jiyaagrawal04/Dhvani/diagrams/DHVANI_Clear_vs_Muddy.png

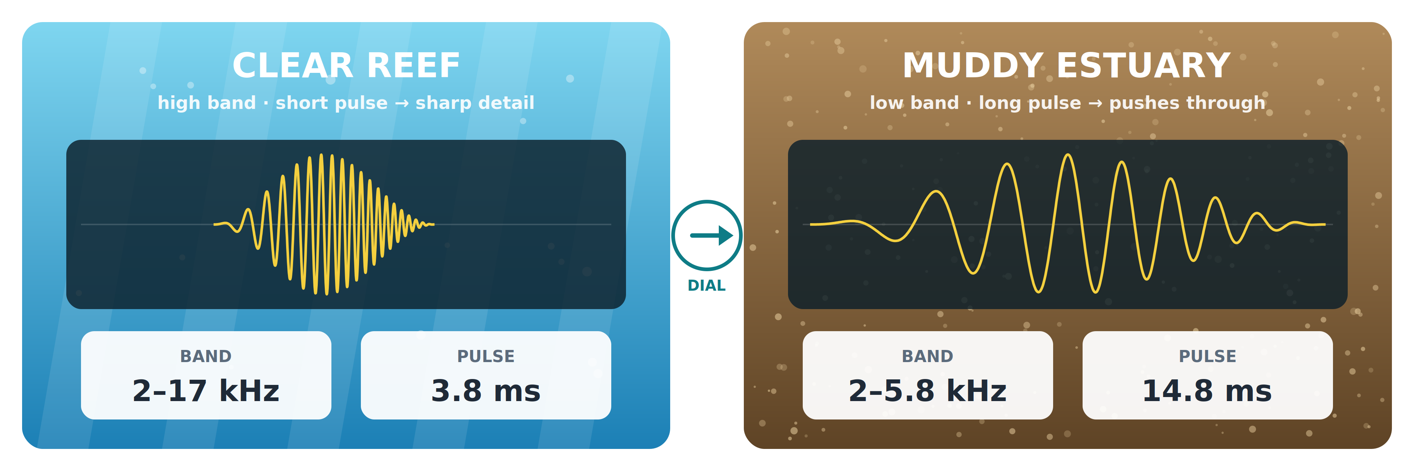
diagrams/DHVANI_Clear_vs_Muddy.png
