jiyaagrawal04/Dhvani/diagrams/DHVANI_Connections.png

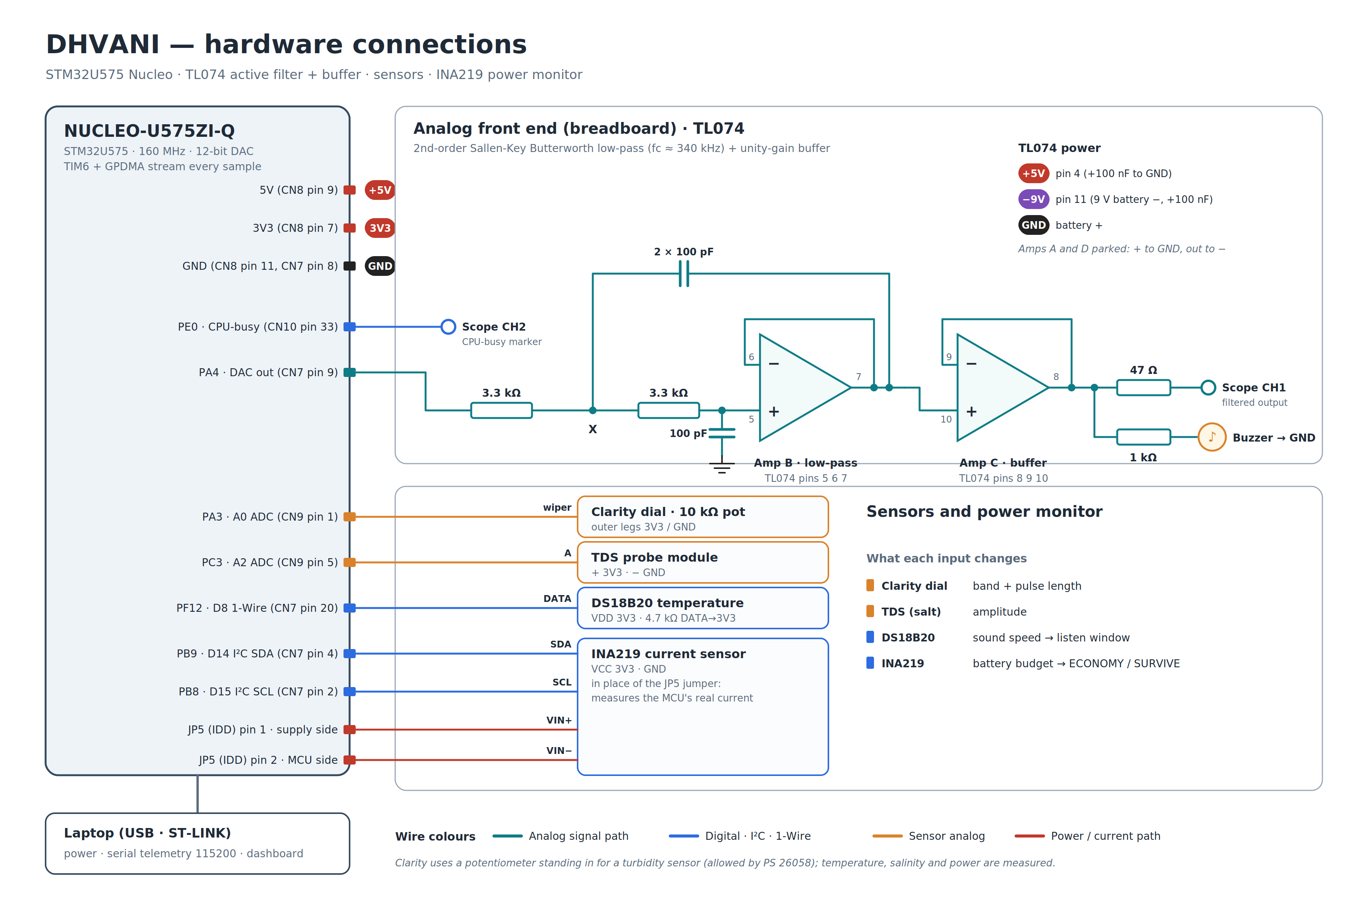
diagrams/DHVANI_Connections.png
