jiyaagrawal04/Dhvani/diagrams/DHVANI_Connections_16x9_4K.png

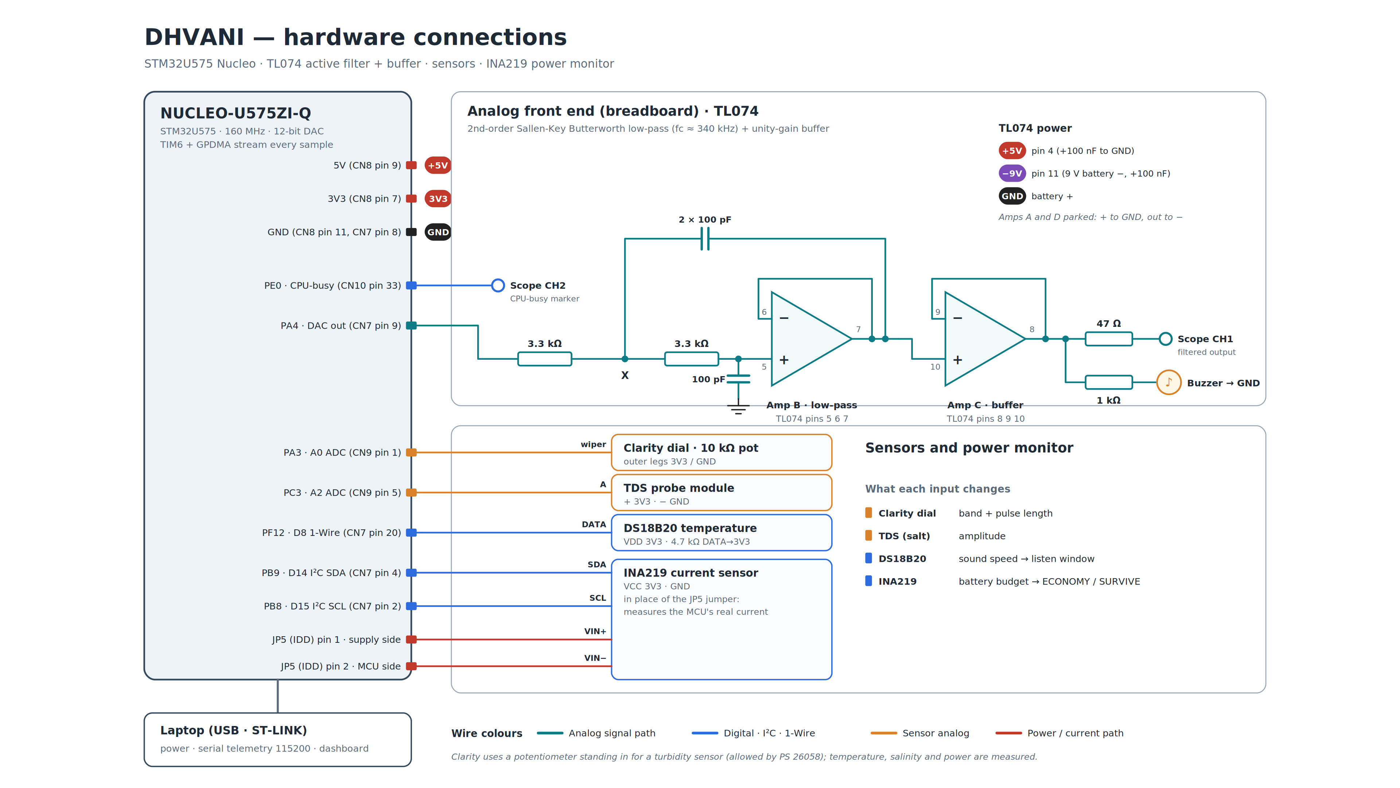
diagrams/DHVANI_Connections_16x9_4K.png
