jiyaagrawal04/Dhvani/diagrams/DHVANI_Pin_Connections.png

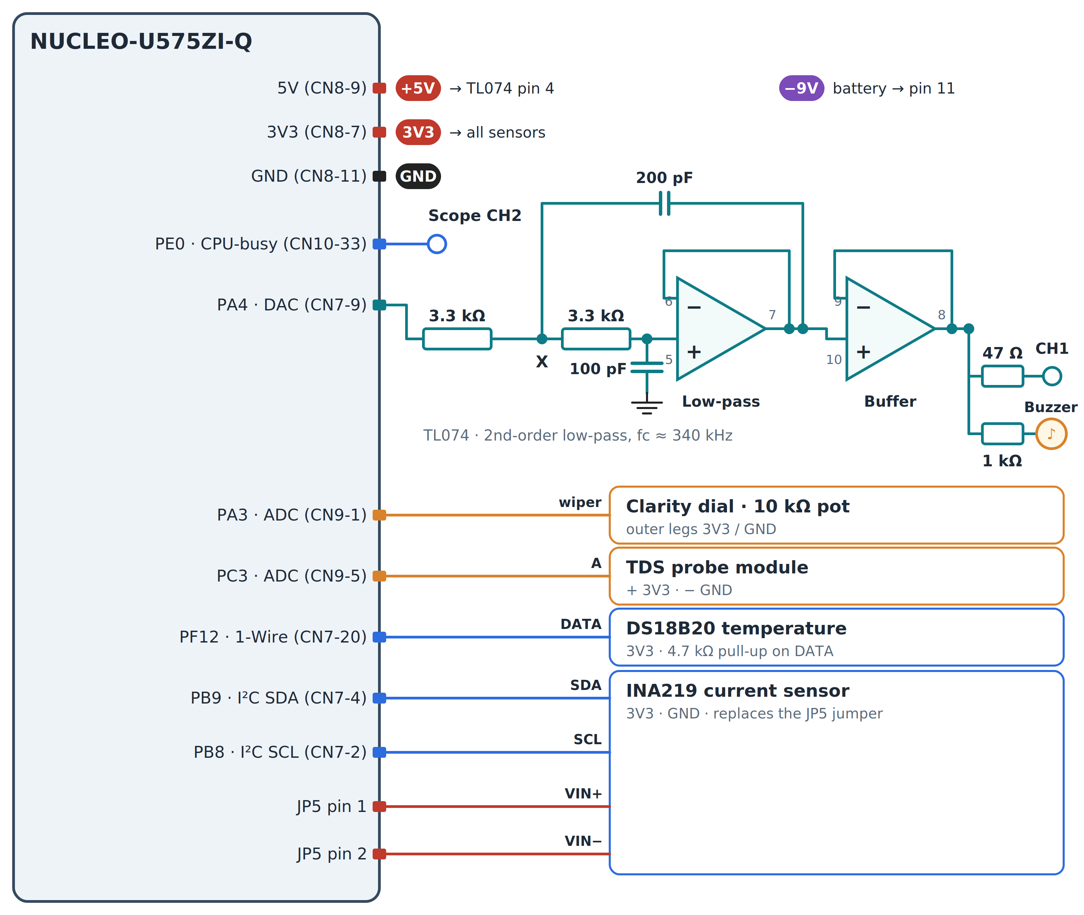
diagrams/DHVANI_Pin_Connections.png
