jiyaagrawal04/Dhvani/diagrams/DHVANI_Pin_Connections_Bold.png

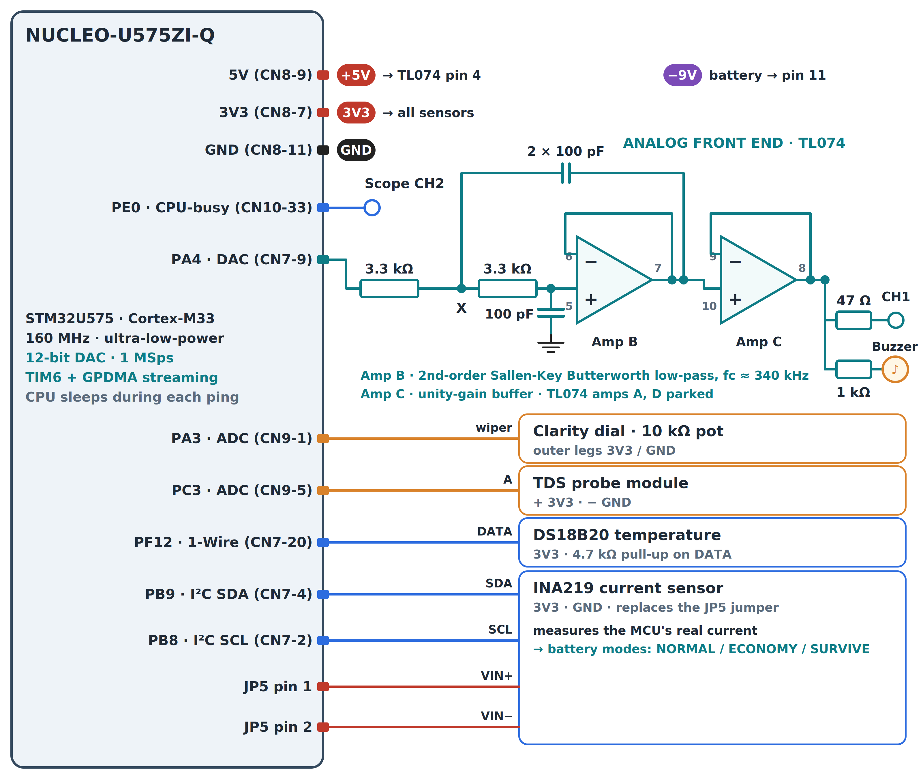
diagrams/DHVANI_Pin_Connections_Bold.png
