jiyaagrawal04/Dhvani/diagrams/DHVANI_Pin_Connections_HalfSlide.png

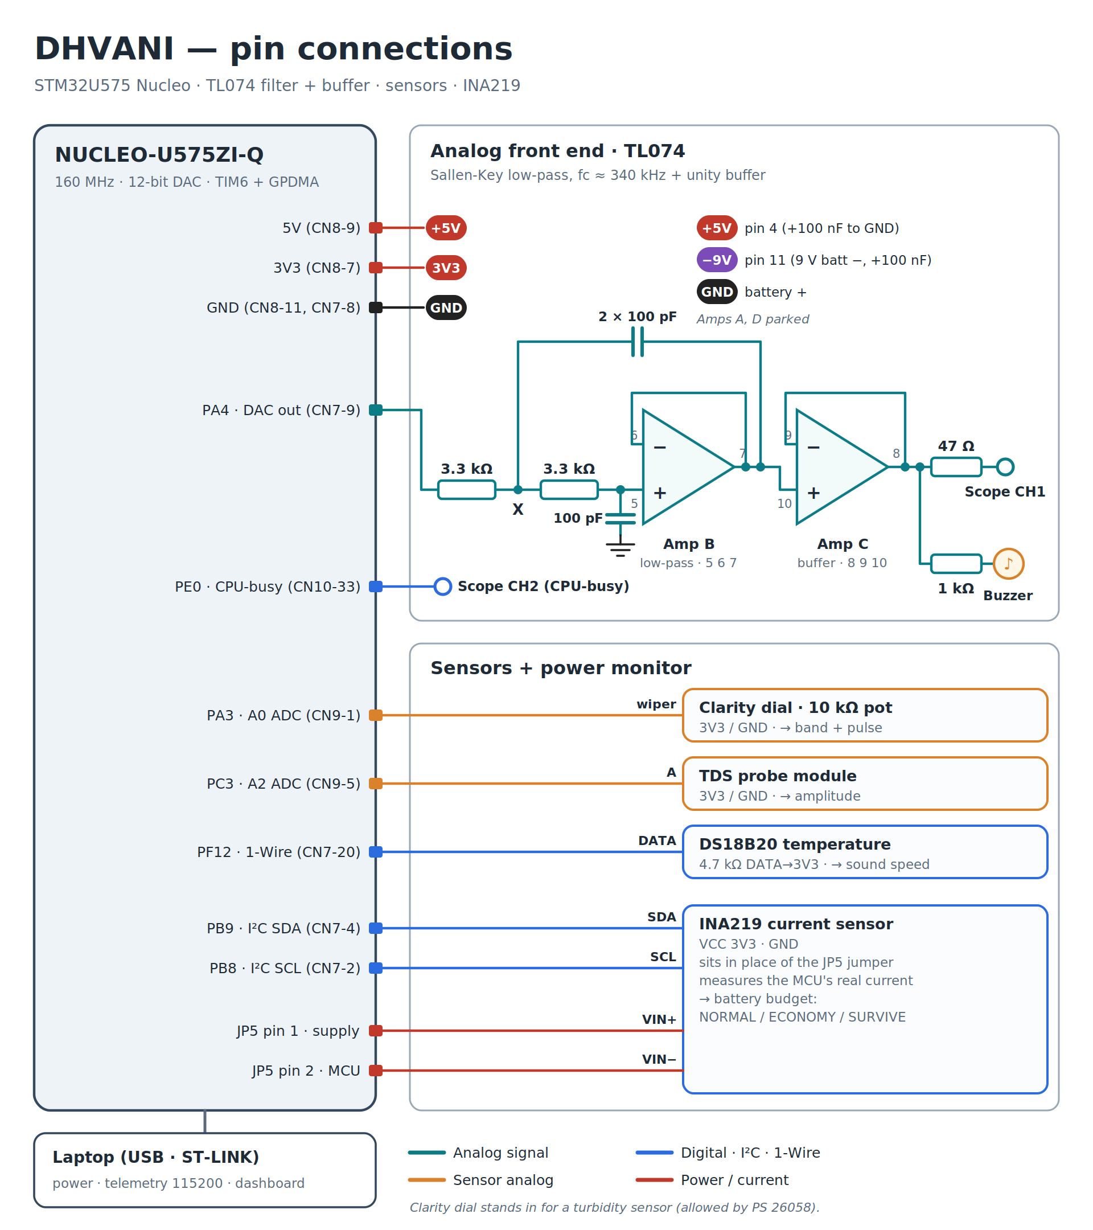
diagrams/DHVANI_Pin_Connections_HalfSlide.png
