jiyaagrawal04/Dhvani/diagrams/DHVANI_Process_Flow.png

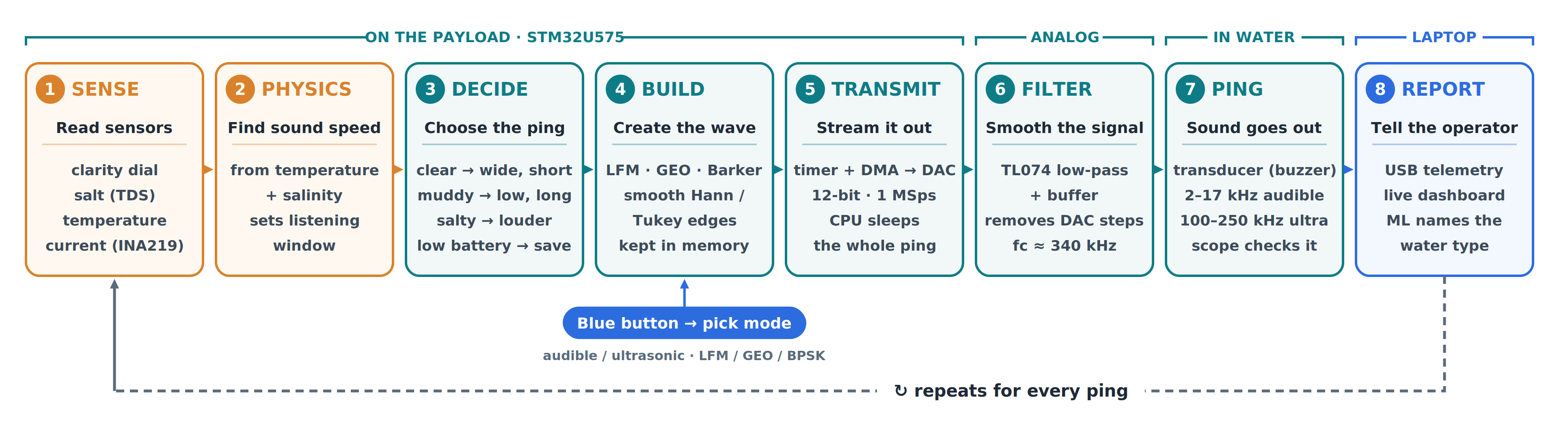
diagrams/DHVANI_Process_Flow.png
