jiyaagrawal04/Dhvani/diagrams/DHVANI_Process_Flow_Designed.png

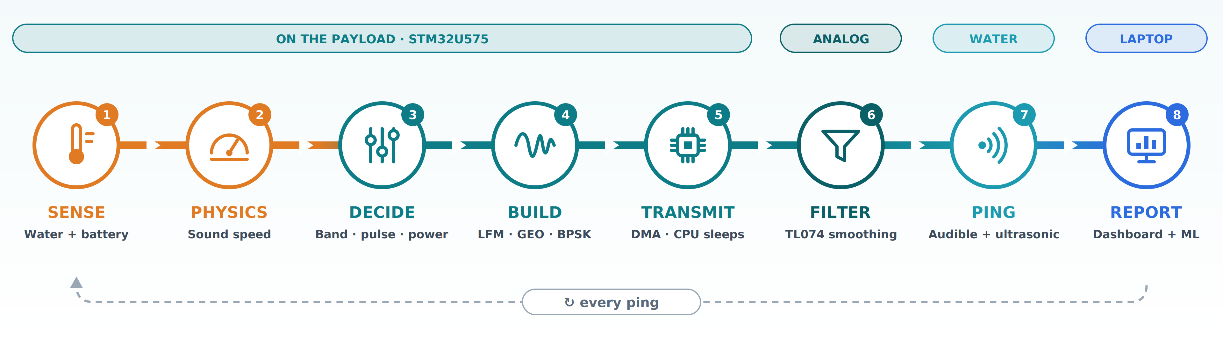
diagrams/DHVANI_Process_Flow_Designed.png
