jiyaagrawal04/Dhvani/diagrams/DHVANI_Process_Flow_Minimal.png

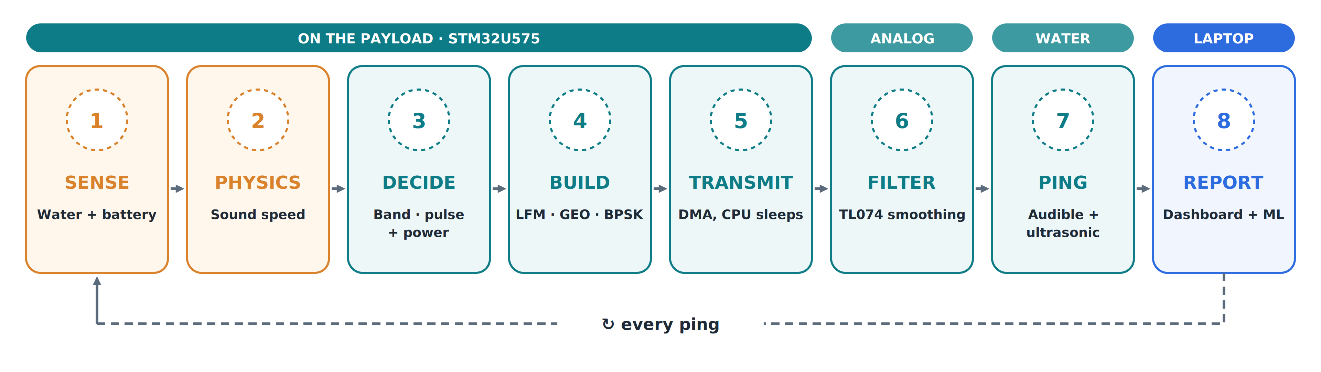
diagrams/DHVANI_Process_Flow_Minimal.png
