jiyaagrawal04/Dhvani/diagrams/DHVANI_Sidelobes_Calculated_16x9.png

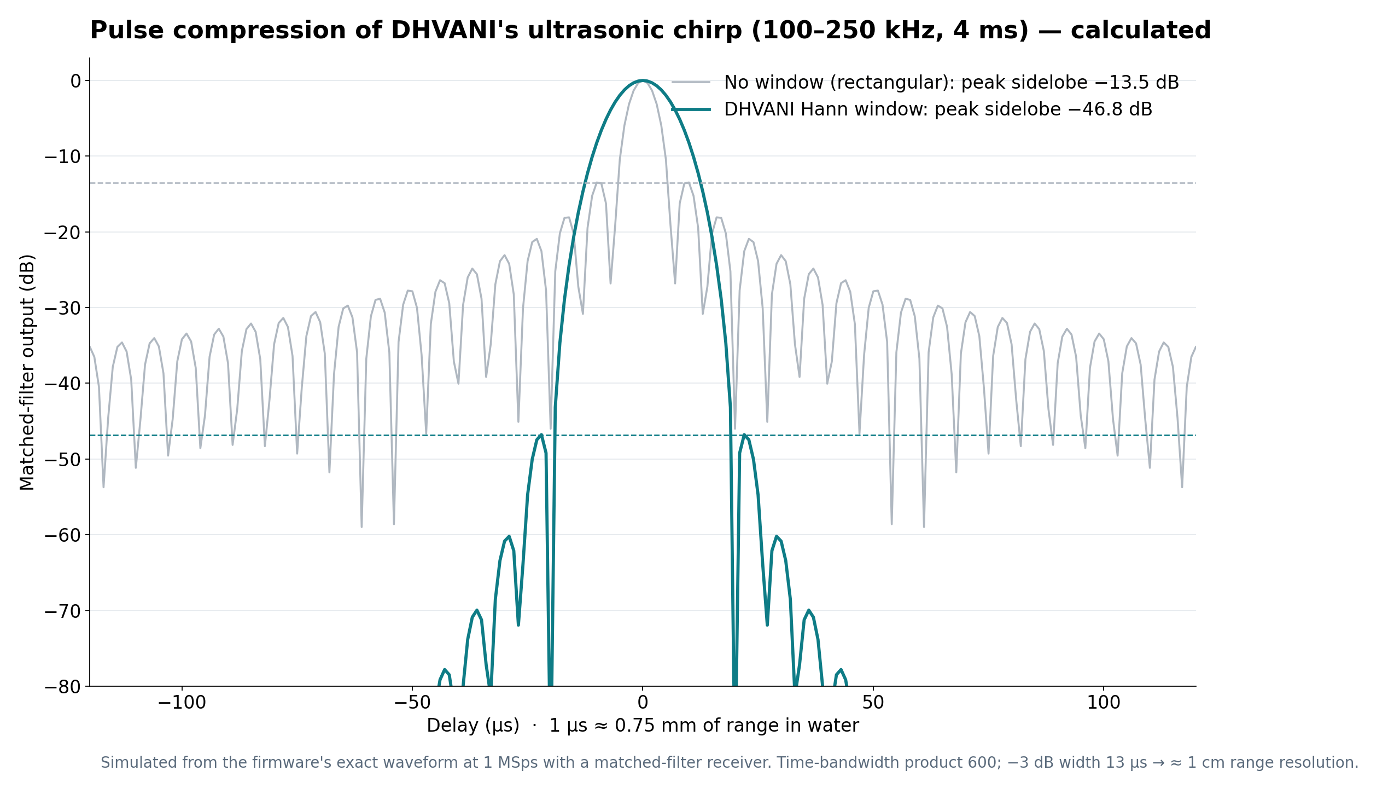
diagrams/DHVANI_Sidelobes_Calculated_16x9.png
