jiyaagrawal04/Dhvani/hardware/pod/DHVANI_Pod_v2_preview.png

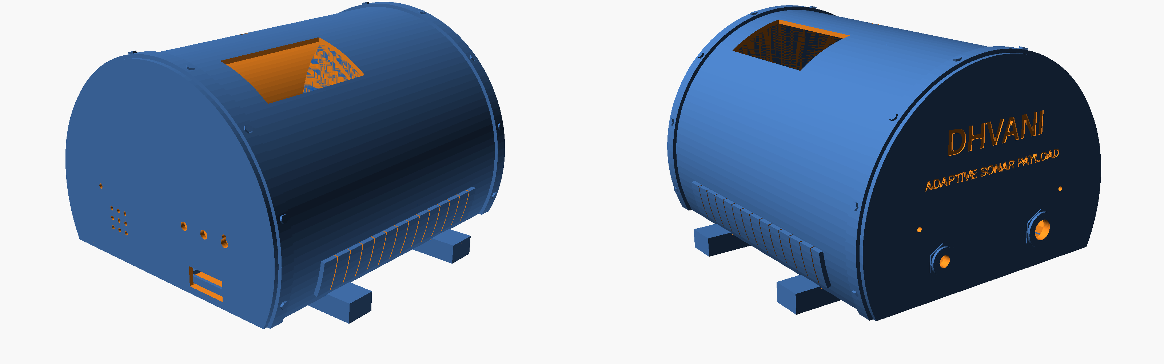
hardware/pod/DHVANI_Pod_v2_preview.png
