jiyaagrawal04/Dhvani/hardware/pod/photos/DHVANI_Pod_buzzer_and_dial.png

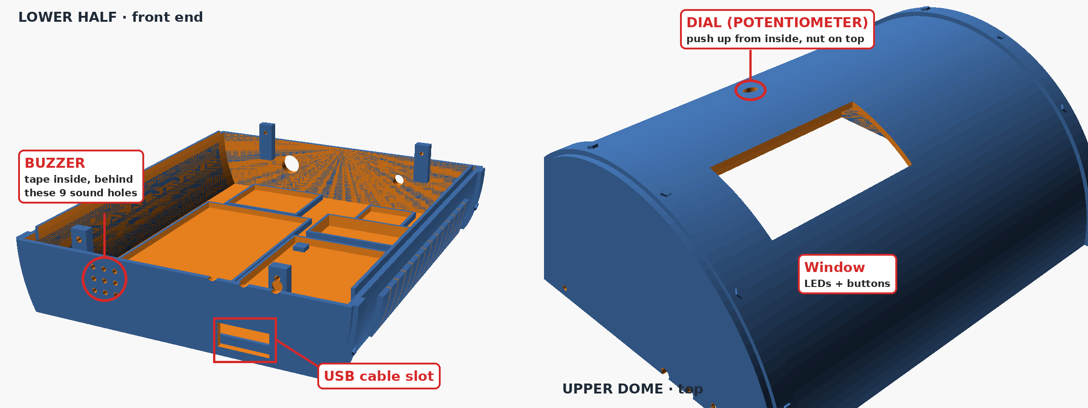
hardware/pod/photos/DHVANI_Pod_buzzer_and_dial.png
