jiyaagrawal04/Dhvani/hardware/pod/photos/DHVANI_Pod_transducer_strip.png

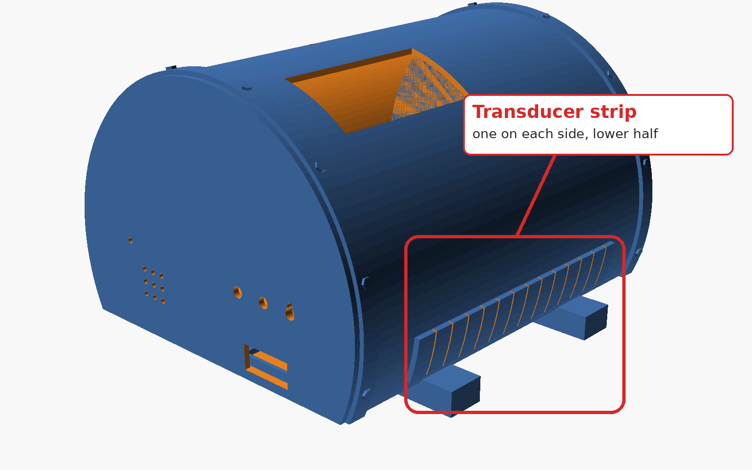
hardware/pod/photos/DHVANI_Pod_transducer_strip.png
