jiyaagrawal04/Dhvani/hardware/pod/photos/DHVANI_Pod_white_rear.png

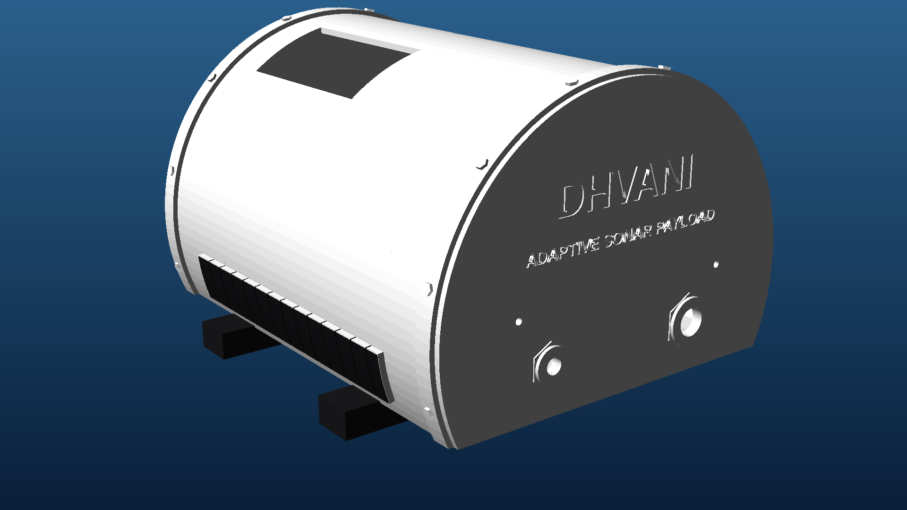
hardware/pod/photos/DHVANI_Pod_white_rear.png
