jiyaagrawal04/Dhvani/hardware/pod/DHVANI_Pod_assembled_VIEW_ONLY.stl

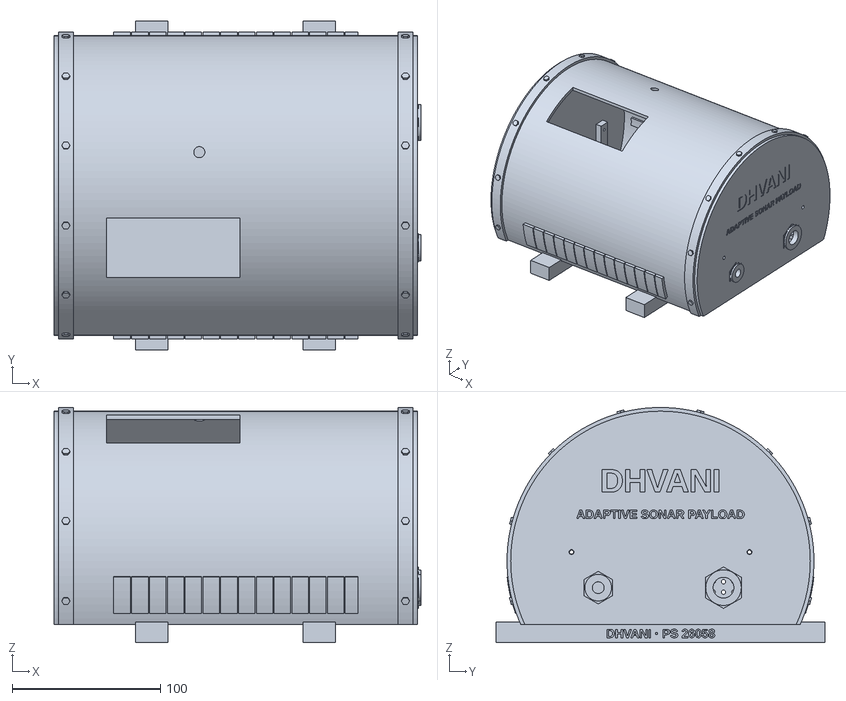
[picture p17: CAD file, 2026-10-15]
hardware/pod/DHVANI_Pod_assembled_VIEW_ONLY.stl
247.5 x 222.0 x 158.5
