jiyaagrawal04/Dhvani/hardware/pod/DHVANI_Pod_lower.stl

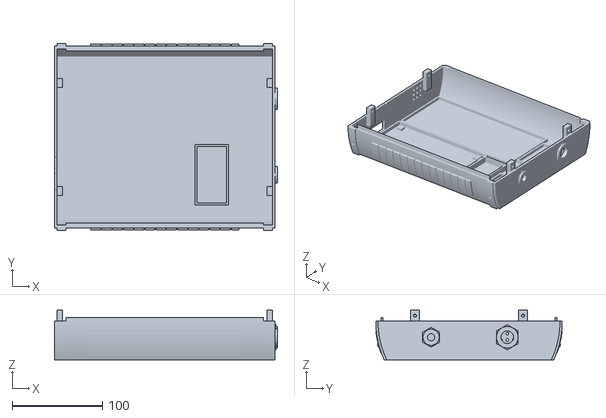
[picture p18: CAD file, 2026-10-15]
hardware/pod/DHVANI_Pod_lower.stl
247.5 x 207.0 x 55.0
