jiyaagrawal04/Dhvani/hardware/pod/DHVANI_Pod_saddle_PRINT_2.stl

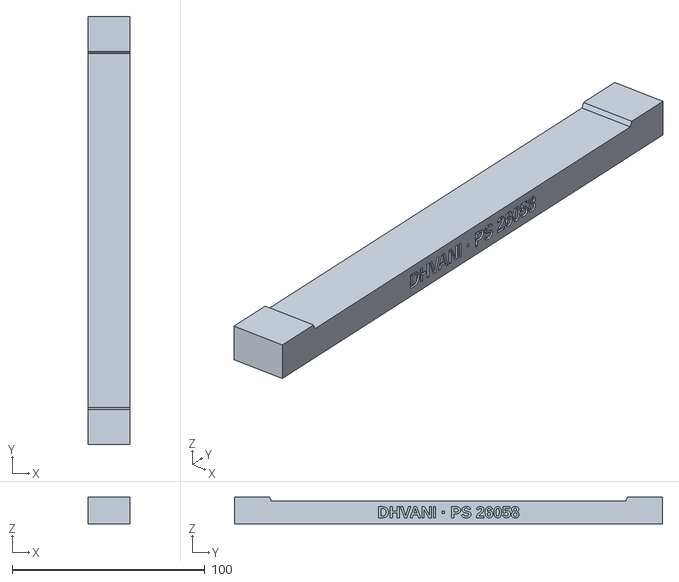
[picture p19: CAD file, 2026-10-15]
hardware/pod/DHVANI_Pod_saddle_PRINT_2.stl
22.0 x 222.0 x 13.9
