jiyaagrawal04/Dhvani/hardware/pod/DHVANI_Pod_upper.stl

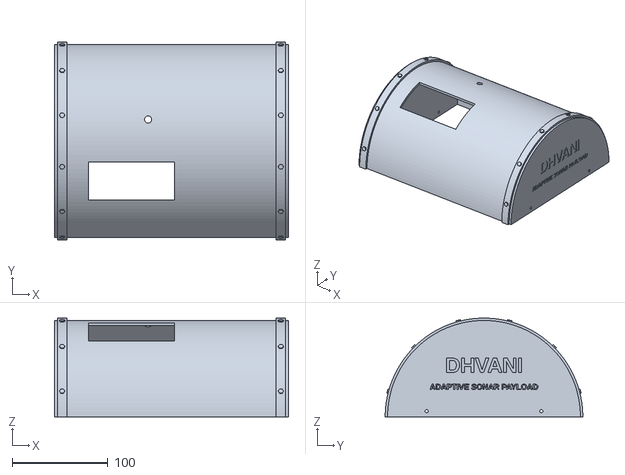
[picture p20: CAD file, 2026-10-15]
hardware/pod/DHVANI_Pod_upper.stl
245.0 x 207.0 x 103.5
