jiyaagrawal04/Dhvani/(list of files, cad)

Other CAD files:
hardware/pod/DHVANI_Pod_FINAL_v3_colour.scad
