jiyaagrawal04/Dhvani/hardware/pod/DHVANI_Pod_Printing_Instructions.pdf

# DHVANI Pod – Printing Instructions

Side-scan sonar payload pod · 5 prints · PLA · fits a 250 mm bed

### Files and colours

File | Qty | Colour
DHVANI_Pod_lower.stl | 1 | Yellow or orange PLA
DHVANI_Pod_upper.stl | 1 | Yellow or orange PLA
DHVANI_Pod_saddle_PRINT_2.stl | 2 | Black or grey PLA
DHVANI_Pod_assembled_VIEW_ONLY.stl | – | Do not print (viewing only)

Paint the long grooved transducer strips on the lower sides black after printing, or swap to black filament when the print reaches them.

### Settings (all parts)

Material | Layer height | Walls | Infill | Brim
PLA | 0.2 mm | 3 | 15% gyroid | On for lower and upper

### Orientation and supports

Part | Place on the bed | Supports
Lower | Flat underside down (as exported) | Tree, build-plate only
Upper | Cut face down (as exported) | Tree, on (inside the dome)
Saddle × 2 | Flat side down | None

### Important

- The two halves are 247.5 mm long: place them straight along the bed's longest direction.
- Don't scale any part; the pockets are sized to the real boards.
- Print the lower half first so the boards can be test-fitted before the dome.
- Check the slicer preview: the top window, the dial hole and the “DHVANI” text should be visible.
- Clean the plate with isopropyl alcohol before each print.

### Hardware for assembly

4 × M3 × 10 mm self-tapping screws · double-sided foam tape
