jiyaagrawal04/Dhvani/diagrams/DHVANI_Hardware_Wiring.png

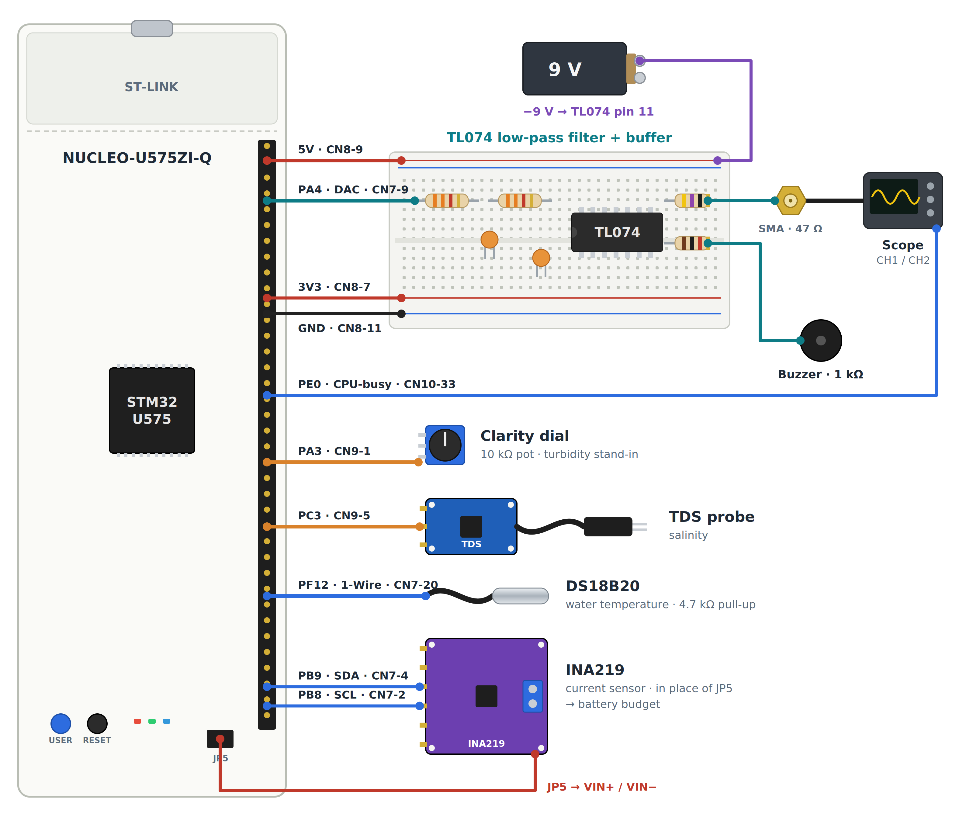
diagrams/DHVANI_Hardware_Wiring.png
