jiyaagrawal04/Dhvani/diagrams/DHVANI_Process_Flow_Designed.pdf

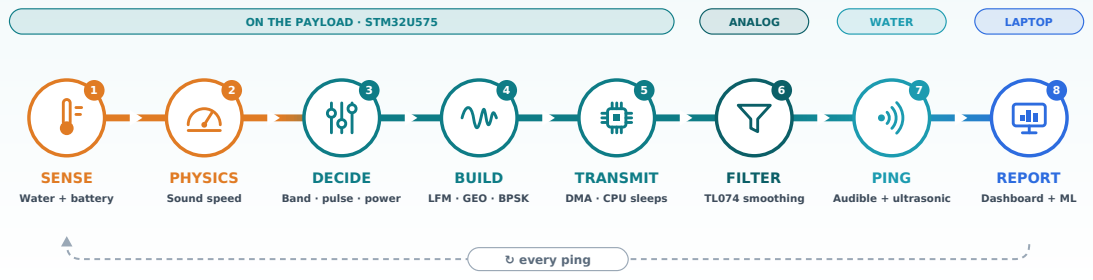
[picture p26: page 1]
ON THE PAYLOAD · STM32U575; ANALOG; WATER; LAPTOP; SENSE; Water + battery; PHYSICS; Sound speed; FILTER; TL074 smoothing; PING; Audible + ultrasonic; REPORT; Dashboard + ML; ↻ every ping

DECIDE
Band · pulse · power

BUILD
LFM · GEO · BPSK

TRANSMIT
DMA · CPU sleeps
