jiyaagrawal04/Dhvani/diagrams/DHVANI_Process_Flow_Minimal.pdf

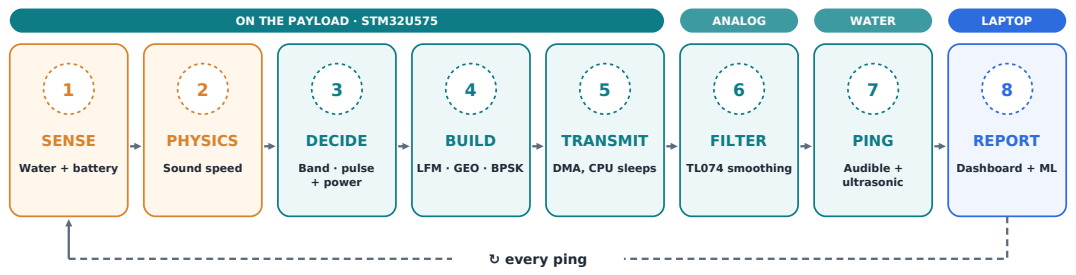
[picture p27: page 1]
ON THE PAYLOAD · STM32U575; ANALOG; WATER; LAPTOP; SENSE; Water + battery; PHYSICS; Sound speed; DECIDE; Band · pulse + power; BUILD; TRANSMIT; FILTER; TL074 smoothing; PING; Audible + ultrasonic; REPORT; Dashboard + ML; ↻ every ping

LFM · GEO · BPSK

DMA, CPU sleeps
