jiyaagrawal04/Dhvani/firmware/Core/Inc/main.h

#define DAC_B2_Pin GPIO_PIN_2
#define DAC_B2_GPIO_Port GPIOE
#define DAC_B3_Pin GPIO_PIN_3
#define DAC_B3_GPIO_Port GPIOE
#define DAC_B4_Pin GPIO_PIN_4
#define DAC_B4_GPIO_Port GPIOE
#define DAC_B5_Pin GPIO_PIN_5
#define DAC_B5_GPIO_Port GPIOE
#define DAC_B6_Pin GPIO_PIN_6
#define DAC_B6_GPIO_Port GPIOE
#define DS18B20_Pin GPIO_PIN_12
#define DS18B20_GPIO_Port GPIOF
#define DAC_B7_Pin GPIO_PIN_7
#define DAC_B7_GPIO_Port GPIOE
#define DAC_B8_Pin GPIO_PIN_8
#define DAC_B8_GPIO_Port GPIOE
#define DAC_B9_Pin GPIO_PIN_9
#define DAC_B9_GPIO_Port GPIOE
#define DAC_B10_Pin GPIO_PIN_10
#define DAC_B10_GPIO_Port GPIOE
#define DAC_B11_Pin GPIO_PIN_11
#define DAC_B11_GPIO_Port GPIOE
#define DAC_B0_Pin GPIO_PIN_0
#define DAC_B0_GPIO_Port GPIOE
#define DAC_B1_Pin GPIO_PIN_1
#define DAC_B1_GPIO_Port GPIOE
